housinabdalsalam-arch/AMZ-SA-26-001/fixture_with_profiles.step

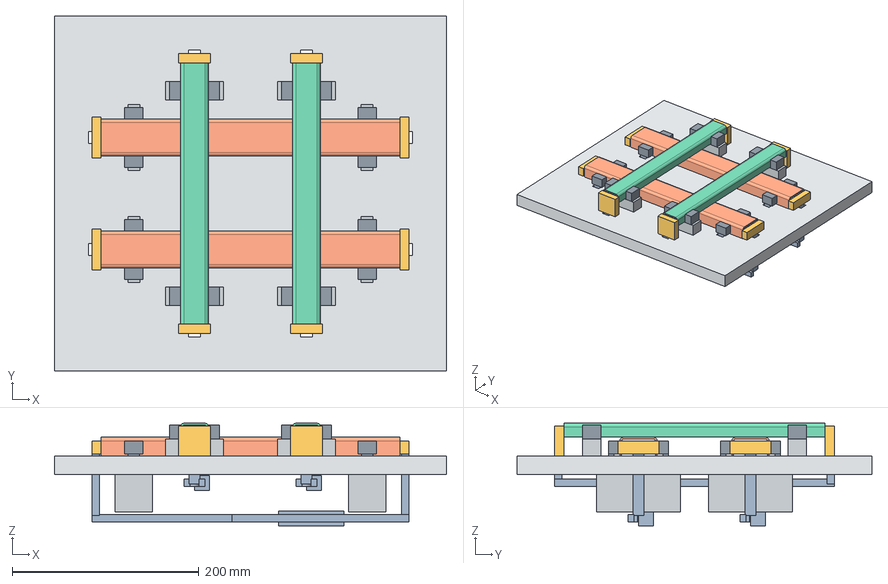
[picture p5: CAD file, 2026-11-08]
fixture_with_profiles.step
420.0 x 380.0 x 110.0 mm
parallel gripper 1
parallel gripper 2
parallel gripper 3
parallel gripper 4
parallel gripper 5
parallel gripper 6
parallel gripper 7
parallel gripper 8
side jaw 1
side jaw 2
side jaw 3
side jaw 4
side jaw 5
side jaw 6
side jaw 7
side jaw 8
side jaw 9
side jaw 10
side jaw 11
side jaw 12
side jaw 13
side jaw 14
side jaw 15
side jaw 16
drive part 1
drive part 2
drive part 3
drive part 4
drive part 5
drive part 6
drive part 7
drive part 8
drive part 9
drive part 10
drive part 11
drive part 12
drive part 13
drive part 14
drive part 15
drive part 16
drive part 17
drive part 18
drive part 19
drive part 20
drive part 21
drive part 22
drive part 23
drive part 24
drive part 25
drive part 26
drive part 27
drive part 28
drive part 29
drive part 30
drive part 31
drive part 32
drive part 33
drive part 34
drive part 35
drive part 36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
