housinabdalsalam-arch/AMZ-SA-26-001/xarm6_meshes/link2.stl

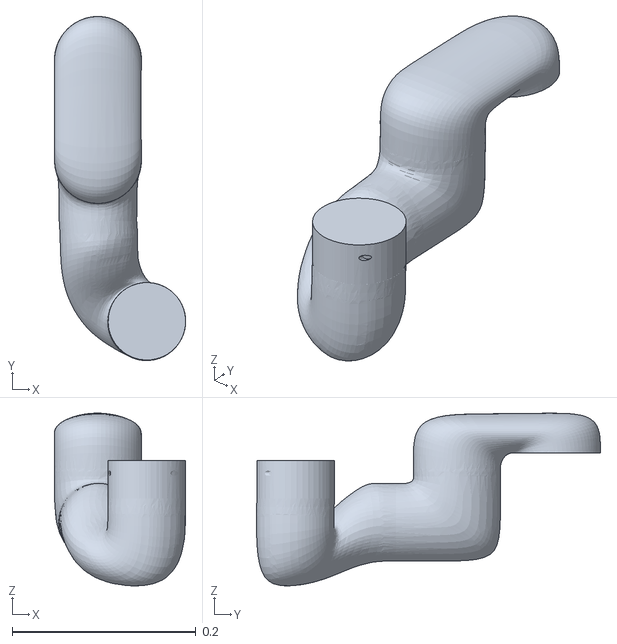
[picture p6: CAD file, 2026-11-08]
xarm6_meshes/link2.stl
0.143 x 0.375 x 0.188
