housinabdalsalam-arch/AMZ-SA-26-001/xarm6_meshes/link4.stl

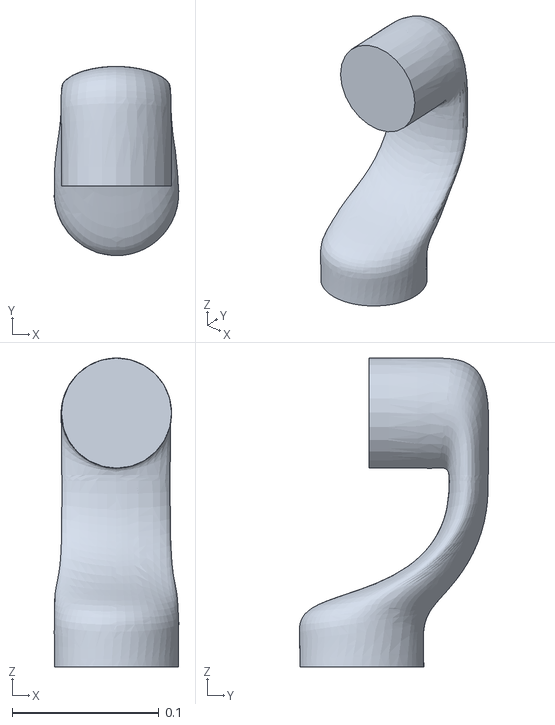
[picture p7: CAD file, 2026-11-08]
xarm6_meshes/link4.stl
0.0849 x 0.129 x 0.211
