housinabdalsalam-arch/AMZ-SA-26-001/xarm6_meshes/link6.stl

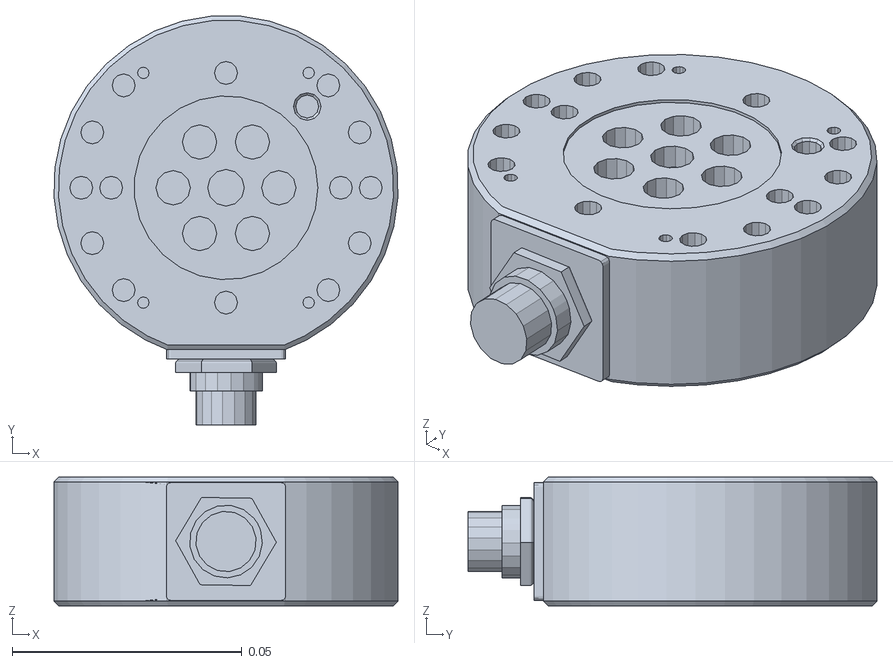
[picture p8: CAD file, 2026-11-08]
xarm6_meshes/link6.stl
0.0749 x 0.089 x 0.028
