housinabdalsalam-arch/AMZ-SA-26-001/xarm6_meshes/link1.stl

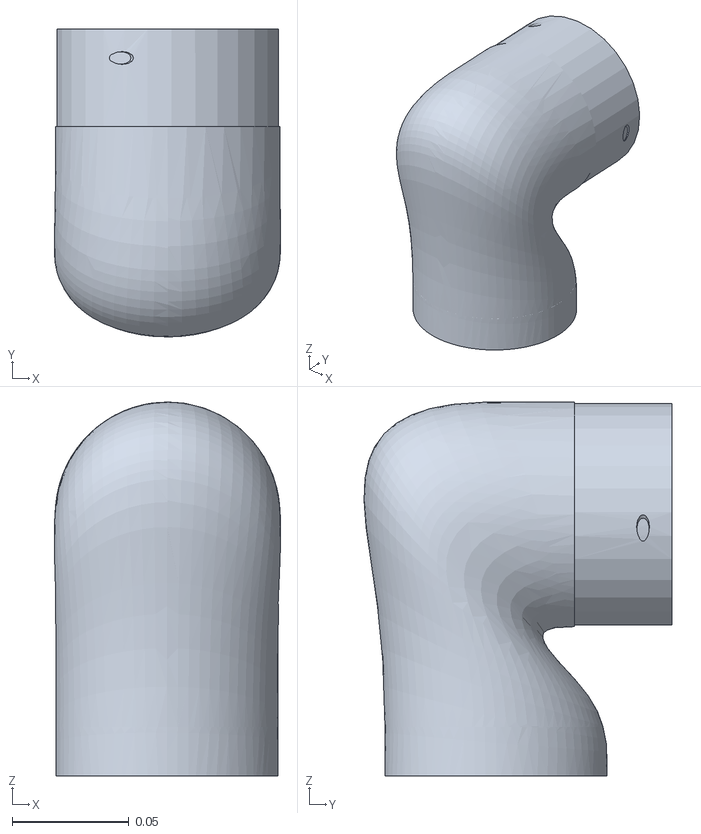
[picture p9: CAD file, 2026-11-08]
xarm6_meshes/link1.stl
0.0969 x 0.132 x 0.16
