housinabdalsalam-arch/AMZ-SA-26-001/xarm6_meshes/link_base.stl

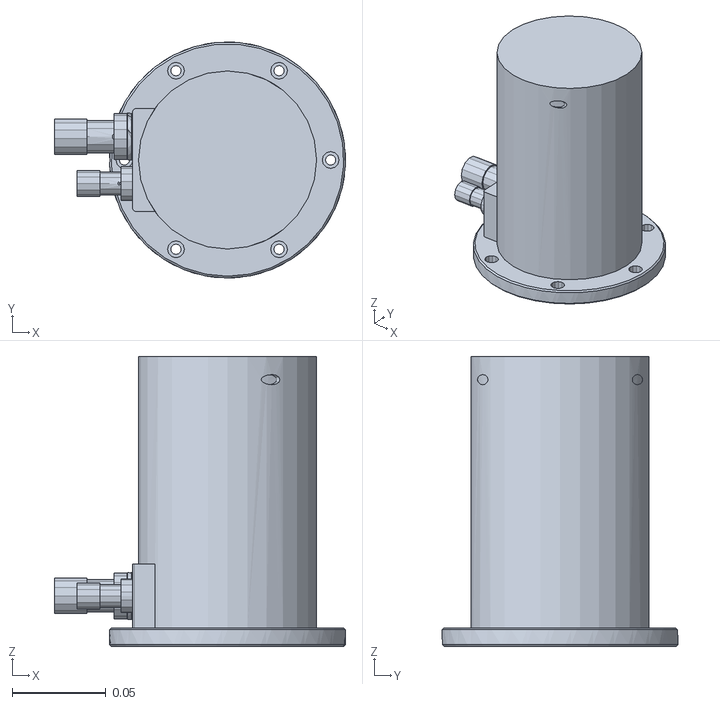
[picture p10: CAD file, 2026-11-08]
xarm6_meshes/link_base.stl
0.155 x 0.126 x 0.155
