housinabdalsalam-arch/AMZ-SA-26-001/xarm6_meshes/link5.stl

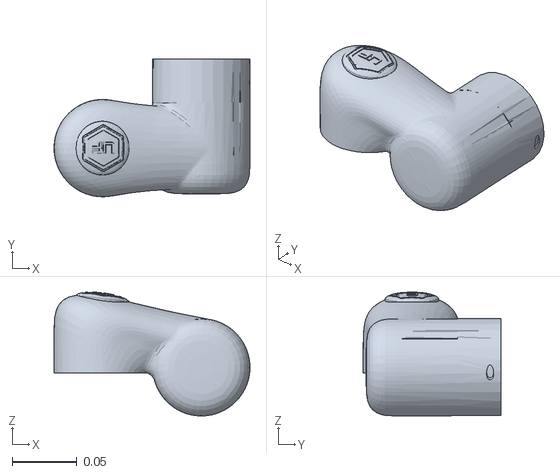
[picture p11: CAD file, 2026-11-08]
xarm6_meshes/link5.stl
0.151 x 0.106 x 0.0955
