housinabdalsalam-arch/AMZ-SA-26-001/xarm6_meshes/link3.stl

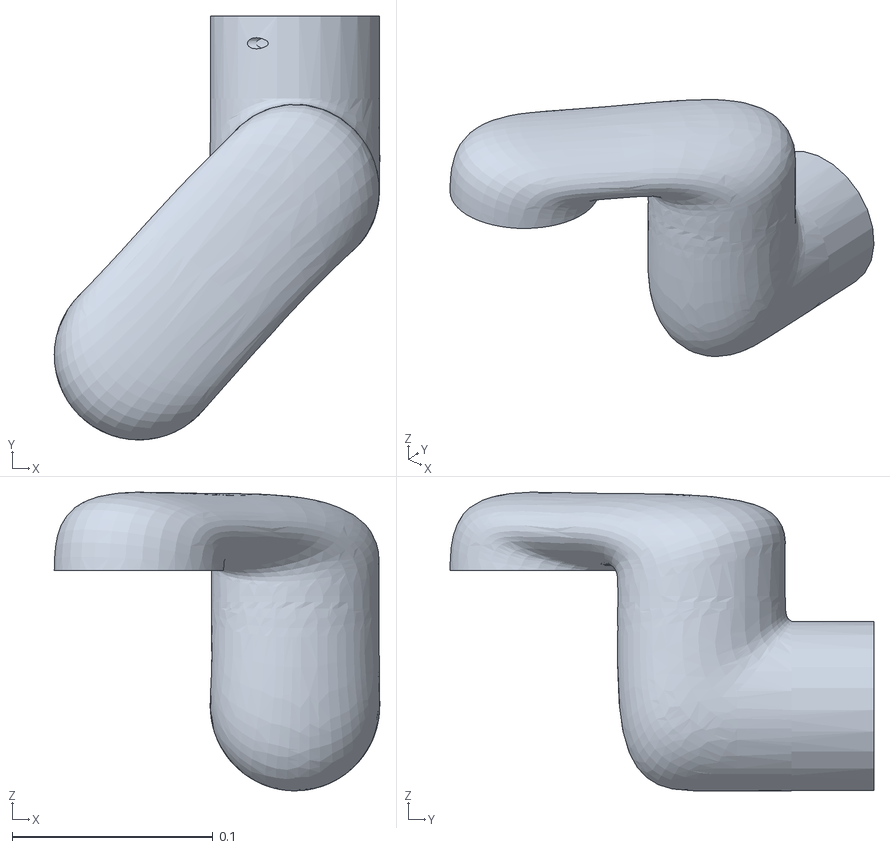
[picture p12: CAD file, 2026-11-08]
xarm6_meshes/link3.stl
0.162 x 0.211 x 0.149
